zero-abd/Roam-E/Team & Vehicle Photos/Team Photos/Serious-team-photo.jpg

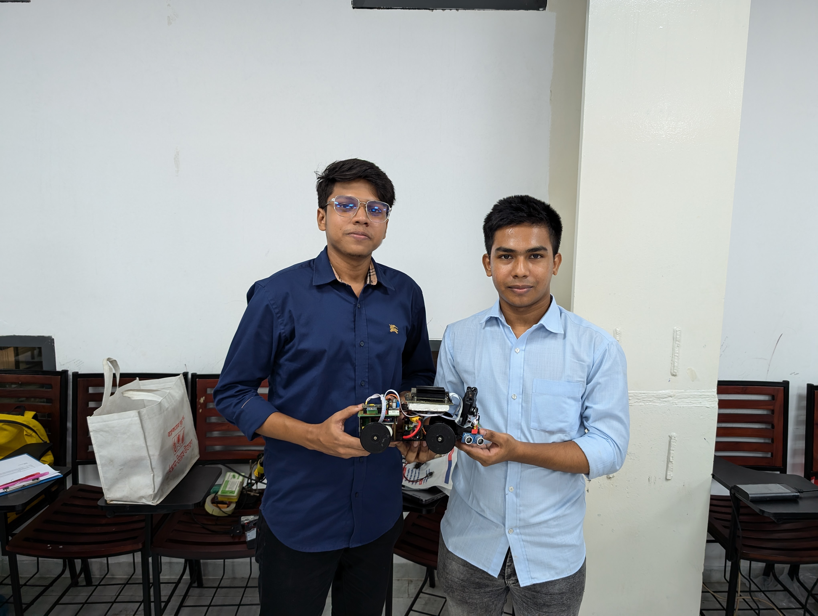
Team & Vehicle Photos/Team Photos/Serious-team-photo.jpg
